RadevSvetlozar/pico_new/HARDWARE_CONNECTIONS_BG.md

# Motherboard за Arduino Nano ESP32 — връзки

Документът отговаря на текущия firmware. Имената `D…` и `A…` са имената,
отпечатани върху Arduino Nano ESP32, а не суровите ESP32 GPIO номера.

## 1. Разпределение на пиновете

| Nano ESP32 | Посока | Връзка | Забележка |
|---|---:|---|---|
| D0 | вход | CONFIG бутон към GND | Активен LOW, използва `INPUT_PULLUP` |
| D1 | — | резерв | Остави test pad |
| D2 | вход | LoRa DIO0 | Не свързвай към RS485 |
| D3 | — | резерв | Остави test pad |
| D4 | вход | Digital input 1 | Само 3.3 V логика/сух контакт |
| D5 | вход | Digital input 2 | Само 3.3 V логика/сух контакт |
| D6 | вход | Digital input 3 | Само 3.3 V логика/сух контакт |
| D7 | изход | W5500 CS/SCS | Добави 10 kΩ pull-up към 3.3 V |
| D8 | вход | W5500 INT | Добави 10 kΩ pull-up към 3.3 V |
| D9 | изход | LoRa RESET | 3.3 V логика |
| D10 | изход | LoRa NSS/CS | Добави 10 kΩ pull-up към 3.3 V |
| D11 | изход | SPI MOSI | Обща линия LoRa + W5500 |
| D12 | вход | SPI MISO | Обща линия LoRa + W5500 |
| D13 | изход | SPI SCK | Обща линия LoRa + W5500 |
| A0 | аналогов вход | NTC divider | 10 kΩ NTC, B=3950 |
| A1 | изход | GSM power-rail enable | Към EN на load switch, не към VBAT |
| A2 | UART RX | SIM7600 TXD | Кръстосана UART връзка |
| A3 | UART TX | SIM7600 RXD | Carrier-ът трябва да приема 3.3 V UART |
| A4 | UART TX | RS485 DI / TXD | В текущия firmware не остава за I²C |
| A5 | UART RX | RS485 RO / RXD| В текущия firmware не остава за I²C |
| A6 | — | резерв | Остави test pad |
| A7 | — | резерв | Остави test pad |

Всички модули трябва да имат обща логическа маса, освен ако интерфейсът не е
галванично изолиран.

## 2. LoRa слот — SX1276/RFM95, 868 MHz

| LoRa module | Nano ESP32 |
|---|---|
| VCC / 3V3 | 3.3 V |
| GND | GND |
| SCK | D13 |
| MISO | D12 |
| MOSI | D11 |
| NSS / CS | D10 |
| RESET | D9 |
| DIO0 | D2 |

Допълнително:

- 100 nF + 10 µF между 3.3 V и GND, максимално близо до слота;
- 470–1000 µF електролитен кондензатор върху 3.3 V rail-а близо до LoRa
  слота, ако захранващият модул и пистите не поемат добре TX импулсите;
- 10 kΩ pull-up от NSS/CS към 3.3 V;
- 868 MHz антена или U.FL/SMA конектор;
- keep-out зона под и пред PCB антената, ако модулът използва такава;
- не включвай предаване без свързана подходяща антена.

Електролитният кондензатор трябва да е поне 6.3 V, low-ESR и с правилна
полярност:

```text
3.3 V ── (+ 470–1000 µF -) ── GND
```

Той не заменя 100 nF и 10 µF керамичните кондензатори непосредствено до
модула.

## 3. LAN слот — W5500 модул

Препоръката е готов 3.3 V W5500 модул/carrier с RJ45 и magnetics, а не гол
W5500 чип.

| W5500 module | Nano ESP32 |
|---|---|
| 3V3 | 3.3 V |
| GND | GND |
| SCK | D13 |
| MISO | D12 |
| MOSI | D11 |
| SCS / CS | D7 |
| INT | D8 |
| RESET | 10 kΩ към 3.3 V и 100 nF към GND |

Добави 100 nF + 10 µF до захранващите пинове на слота. LoRa и W5500 споделят
SPI, но всеки има отделен CS. И двата CS трябва да са HIGH по време на reset.
Дръж Ethernet differential pair-ите къси и следвай reference layout-а на
избрания carrier/RJ45.

## 4. GSM/LTE слот — SIM7600 carrier

Използвай carrier, който:

- приема отделно 5 V захранване с достатъчен пиков ток;
- има auto-start при подаване на захранване;
- има 3.3 V-съвместим UART;
- извежда SIM holder и антенен конектор.

| SIM7600 carrier | Motherboard |
|---|---|
| 5V/VIN | отделна GSM 5 V rail |
| GND | обща GND |
| TXD | Nano A2 (RX) |
| RXD | Nano A3 (TX) |
| GSM rail EN | Nano A1 чрез load-switch EN |
| MAIN ANT | LTE антена |
| GNSS ANT | GNSS антена, само ако се използва |

`A1` не захранва модема. Той управлява EN на подходящ load switch или enable
на GSM buck regulator. Добави 100 kΩ pull-down на EN, за да е изключен rail-ът
при reset.

За GSM rail предвиди според carrier-а поне:

- 5 V / 3 A buck regulator;
- 470–1000 µF low-ESR bulk capacitor близо до слота;
- 10 µF + 100 nF ceramic capacitors;
- широка power писта/полигон и директен ground return;
- SIM и LTE ESD защита според reference design-а на carrier-а.

Не свързвай директно гол SIM7600 module към 3.3 V UART или към 5 V без
съответния reference power/level-shifting design.

## 5. RS485 порт

Текущият firmware не управлява DE/RE, затова използвай 3.3 V RS485 модул с
автоматична посока.

| Auto-direction RS485 | Nano ESP32 |
|---|---|
| VCC | 3.3 V |
| GND | GND |
| RO / TXD | A5 (RX) |
| DI / RXD | A4 (TX) |
| A | Клема RS485 A |
| B | Клема RS485 B |

До външния конектор добави:

- SM712 или еквивалентна RS485 TVS защита;
- 120 Ω termination с jumper/DIP switch;
- fail-safe bias резистори с jumper, само на едно място в шината;
- GND/reference клема;
- по възможност galvanically isolated RS485 вариант за индустриална среда.

Не поставяй постоянно 120 Ω на всяка платка — termination има само в двата
физически края на шината.

## 6. Три цифрови входа

Firmware-ът конфигурира D4, D5 и D6 като `INPUT_PULLUP`.

За локален сух контакт:

```text
3.3 V ── 10 kΩ ──┬── D4/D5/D6
                  |
               контакт
                  |
                 GND
```

Добави 1 kΩ последователен резистор към MCU пина и 100 nF към GND за хардуерен
филтър. Отворен контакт се чете като `1`, затворен като `0`.

За 12/24 V полеви вход не свързвай сигнала директно. Използвай optocoupler или
industrial digital-input front-end. Примерно за 24 V и обикновен optocoupler:

```text
FIELD+ ── 4.7 kΩ / 0.25 W ── opto LED ── FIELD-
3.3 V  ── 10 kΩ ──┬── D4/D5/D6
                   └── opto collector
GND ─────────────────── opto emitter
```

Добави reverse diode през opto LED и подходяща surge/ESD защита на конектора.

## 7. NTC термистор

Кодът на Nano ESP32 е за 10 kΩ NTC, B=3950, и 10 kΩ фиксиран резистор:

```text
3.3 V ── NTC 10 kΩ/B3950 ──┬── A0
                            |
                           10 kΩ 1%
                            |
                           GND
```

Добави 100 nF от A0 към GND. Постави термистора далеч от SIM7600, buck
регулаторите и други топли компоненти, ако целта е температура на околната
среда.

## 8. CONFIG бутон и сервизни връзки

```text
3.3 V ── 10 kΩ ──┬── D0
                  |
               бутон
                  |
                 GND
```

Firmware-ът активира и вътрешния pull-up; външният 10 kΩ е препоръчителен за
по-стабилна motherboard схема.

Последователност за Access Point:

1. Натисни и задръж CONFIG бутона.
2. Рестартирай Nano ESP32 или изключи и включи захранването.
3. Продължи да държиш бутона, докато започне индикацията за setup mode.
4. Свържи се към `ESP32-Setup` и отвори `http://192.168.10.1`.

Пинът се проверява само по време на startup. Натискане без рестарт няма да
стартира портала. Остави test pads за 3.3 V, GND, D1, D3, A6 и A7.

## 9. Захранване от 230 VAC към 3.3 VDC

Използвай само галванично изолиран, сертифициран и затворен AC/DC модул.
Мрежовата 230 VAC част не трябва да бъде достъпна от нисковолтовите конектори,
USB, бутоните или монтажните отвори.

```text
L ── предпазител ── AC/DC L
N ──────────────── AC/DC N
PE ─────────────── защитно заземяване/корпус, когато е приложимо

Изолиран AC/DC 3.3 V+
   ├── Nano ESP32 3V3
   ├── LoRa VCC
   ├── W5500 3V3
   └── 3.3 V RS485 logic

Изолиран AC/DC 3.3 V-
   └── обща нисковолтова GND
```

За директно захранване на Nano ESP32 през `3V3` трябва да прекъснеш означената
`3.3V` писта/jumper от долната страна на Arduino платката, както е описано от
Arduino. След прекъсването USB не може да захранва платката и не трябва да се
използва за upload, докато връзката не бъде възстановена със спойка. Не
включвай едновременно външните 3.3 V и USB.

3.3 V rail-ът трябва да е добре регулиран и да не превишава допустимото
напрежение на Nano ESP32 и модулите. Предвиди достатъчен ток за Nano ESP32,
Wi-Fi, W5500, LoRa TX и RS485 едновременно, с резерв за стартови импулси.

SIM7600 не трябва да се включва към този 3.3 V rail. За него остави отделен
изолиран AC/DC или DC/DC източник според входа на избрания carrier, обичайно
5 V с висок пиков ток:

```text
Отделен изолиран GSM supply ── load switch ── SIM7600 carrier VIN
                                      EN ──── Nano A1
GSM supply GND ────────────────────────────── low-voltage GND
```

Ако искаш един общ AC/DC модул за цялата платка, избери по-високо DC
напрежение и направи отделни 3.3 V и GSM rails с два DC/DC преобразувателя.

До всеки слот сложи отделен 100 nF и поне 10 µF. До входния конектор предвиди
подходящ предпазител. Спазвай creepage/clearance разстоянията от datasheet-а
на AC/DC модула и приложимия стандарт; не прокарвай copper pour или
нисковолтови писти през isolation зоната.

## 10. PCB layout checklist

- Не прокарвай SPI/UART/analog линии под LTE или LoRa антените.
- Остави copper keep-out според документацията на конкретната антена.
- Дръж W5500/RJ45 Ethernet pair-ите като 100 Ω differential и следвай
  reference design-а на избрания модул.
- Дръж NTC/A0 далеч от buck inductors, SIM7600 и RF линии.
- Постави GSM bulk capacitor максимално близо до GSM слота.
- Постави ESD/TVS елементите непосредствено до външните конектори.
- Добави ясни silkscreen означения за pin 1, напрежение и ориентация на всеки
  сменяем модул.
- Не допускай едновременно активни CS линии D7 и D10.
- Ако ще използваш I²C в бъдеще, премести RS485 от A4/A5 и промени firmware-а.
