RadevSvetlozar/pico_new/RADIO_ANALYSIS_BG.md

# Дистанционно сканиране с известни UID първо

Изисква ESP32 1.4.23, Node.js и frontend от тази промяна. Pro Mini и радио
протоколът не се променят. Използват се съществуващите UID/v2 заявки и TTL.

## Последователност

1. Известните UID се събират от записаните устройства, по-ранни отчети,
   успешни индивидуални ping проверки и профилите в ESP32 NVS.
2. ESP32 проверява всеки известен UID последователно: 3 радио-only заявки
   с TTL 0. Ако има директен отговор, препращане не се пробва.
3. Само при 0/3 директни отговора се правят още 3 опита с TTL 2.
4. След проверката на известните UID има три broadcast discovery прохода
   за нови платки. Потвърдените платки остават в текущия отчет независимо
   дали broadcast-ът ги намира. Broadcast не е критерий за изтриване.
5. Новооткритите UID се проверяват по същия директен/резервен режим.

Известният UID се помни, но това не означава постоянно reachable. Всеки
нов анализ събира нови отговори; липсващите показват 0/3, а не фалшив успех.
Лимитът е 8 проверявани UID за анализ. Отчетът отбелязва ограничението,
ако има още кандидати. До 12 минути при много недостъпни платки.

Когато се подаде node_uid без analyze=true (например проверка при добавяне
на устройство), ESP32 проверява само този UID, без broadcast discovery.
Това премахва зависимостта на индивидуалната проверка от общото откриване.

## Използване и резултати

MQTT устройства → Радио сканиране — на живо → „Анализирай радио мрежата“.
Стартът връща HTTP 202; страницата следи API и live MQTT/Bluetooth събития.
Отчетът се пази в PostgreSQL radio_analysis_reports. radio_known_nodes
пази установените UID между отделни сканирания и рестарти на сървъра.
ESP32 пази предпочитанията в NVS config/radioProfiles.

Отчетът съдържа scan_strategy=known_uid_first и по UID брой опити/отговори,
процент и средно време/RSSI/SNR. relay_tested=false означава, че не са
правени relay опити, защото има директен отговор; това не е 0% успеваемост.
Три опита са малка извадка, а не гаранция за дългосрочна надеждност.

Радио-only пробата използва неподдържан CAN target/function 0. Инсталираният
UID firmware на Pro Mini връща unsupported_function без Modbus/GPIO достъп.
Всеки корелиран отговор е радио успех. Modbus 226 не е радио timeout.
TTL 2 позволява препращане, но не доказва конкретен маршрут. Discovery path
описва заявката, а не гарантиран обратен път.

По време на анализа polling-ът е паузиран; нови заявки получават busy.
Анализът се отказва, ако има чакащи writes. Read може да се повтори веднъж
с другия TTL; write не се повтаря автоматично. Явно зададеният TTL има
предимство пред профила. При три пропуснати автоматични заявки се сменя
предпочитаният TTL и се маркира needs_recheck.

POST/GET /api/device-onboarding/lora-analysis използват gateway_id и Bearer
токен. Dev/developer/admin и ROLE_ вариантите имат достъп като в MQTT
регистъра; останалите потребители — само до своите обекти. Индивидуалният
POST /api/device-onboarding/lora-ping продължава да работи с ESP32 1.4.22.

Промените не са физически проверени върху отдалечените платки. За новата
последователност се обновява само ESP32 (OTA), backend и frontend.
