RadevSvetlozar/pico_new/pcb-motherboard/README_BG.md

# Nano ESP32 modular gateway – PCB rev A

Това е прототипна двуслойна motherboard за Arduino Nano ESP32 с места за:

- RFM95W LoRa (16 × 16 mm, 2 mm pitch; използва се адаптер с пинове);
- XY-485 с 4-пинов TTL конектор `GND RXD TXD VCC`;
- WIZ850io Ethernet;
- Waveshare SIM7600G-H HAT;
- 38 × 23 mm капсулован AC/DC модул 230 VAC → 3.3 VDC;
- AP/config бутон, NTC 10 kΩ, три локални входа и филтриращ кондензатор.

RS485 UART връзката е кръстосана: `A4 (Nano TX)` отива към `RXD/DI` на
XY-485, а `A5 (Nano RX)` идва от `TXD/RO` на XY-485. Това съответства на
`TX1_PIN = A4` и `RX1_PIN = A5` във firmware-а.

## Важна безопасност

Зоната вляво от вертикалната линия е под опасно мрежово напрежение. Платката е
прототип и **не е сертифицирана**. Преди включване към 230 VAC трябва да бъде
прегледана от квалифициран електротехник. Използвай затворена негорима кутия,
предпазител T500 mA, MOV 275 VAC и защитена клема. Не пипай и не свързвай USB,
докато платката е под мрежово напрежение.

SIM7600 не се захранва от 3.3 V модула. Подай отделни стабилизирани 5 V / минимум
3 A на клема `GSM 5V`, като масата е обща.

## Печат

PDF файловете са 1:1. Изключи `Fit to page` и печатай на 100%.

- `B_Cu_MIRRORED_1TO1.pdf` – долен меден слой, огледален за тонер трансфер.
- `F_Cu_1TO1.pdf` – горен слой. За домашна изработка може да се реализира с
  изолирани проводникови мостове вместо второ ецване.
- `FABRICATION_DRAWING_1TO1.pdf` – контур, отвори и надписи за проверка.

Преди ецване измери тестовия квадрат и физическите модули. Евтините XY-485 и
AC/DC модули имат различни ревизии; не пробивай, ако разстоянията не съвпадат.

## Размерен чертеж и таблици

[DIMENSIONS_BG.html](dimensions/DIMENSIONS_BG.html) съдържа разположение,
чертежи на двата медни слоя и пълни таблици за 19 елемента/монтажни места,
130 площадки и 139 сегмента на пистите. Всички координати са в mm спрямо
горния ляв край на платката. SVG чертежите са за печат 1:1 на A4 landscape,
100%, без автоматично мащабиране. Таблиците са налични и като CSV.

Размерите са извлечени от действителния `.kicad_pcb` файл чрез
`python3 generate_dimensions.py`. Нарисуваните контури на модулите са места
от проекта, а не проверени физически габарити. Документът не удостоверява
DRC, токова натоварваемост или изолация за 230 VAC.
