RadevSvetlozar/pico_new/pcb-motherboard/dimensions/pads.csv

ref | pin | x_mm | y_mm | pad_x_mm | pad_y_mm | drill_mm | net
H3 | 1 | 5.0 | 133.0 | 6.0 | 6.0 | 3.2
H1 | 1 | 5.0 | 5.0 | 6.0 | 6.0 | 3.2
J3 | 1 | 176.0 | 116.0 | 3.2 | 3.2 | 1.3 | +5V_GSM
J3 | 2 | 181.08 | 116.0 | 3.2 | 3.2 | 1.3 | GND
C1 | 1 | 64.0 | 13.0 | 2.4 | 2.4 | 0.9 | +3V3
C1 | 2 | 69.0 | 13.0 | 2.4 | 2.4 | 0.9 | GND
U5 | 1 | 176.0 | 50.0 | 2.2 | 2.2 | 1.0 | GSM_P1
U5 | 2 | 178.54 | 50.0 | 2.2 | 2.2 | 1.0 | +5V_GSM
U5 | 3 | 176.0 | 52.54 | 2.2 | 2.2 | 1.0 | GSM_P3
U5 | 4 | 178.54 | 52.54 | 2.2 | 2.2 | 1.0 | +5V_GSM
U5 | 5 | 176.0 | 55.08 | 2.2 | 2.2 | 1.0 | GSM_P5
U5 | 6 | 178.54 | 55.08 | 2.2 | 2.2 | 1.0 | GND
U5 | 7 | 176.0 | 57.62 | 2.2 | 2.2 | 1.0 | GSM_P7
U5 | 8 | 178.54 | 57.62 | 2.2 | 2.2 | 1.0 | A2_RX
U5 | 9 | 176.0 | 60.16 | 2.2 | 2.2 | 1.0 | GND
U5 | 10 | 178.54 | 60.16 | 2.2 | 2.2 | 1.0 | A3_TX
U5 | 11 | 176.0 | 62.7 | 2.2 | 2.2 | 1.0 | GSM_P11
U5 | 12 | 178.54 | 62.7 | 2.2 | 2.2 | 1.0 | GSM_P12
U5 | 13 | 176.0 | 65.24 | 2.2 | 2.2 | 1.0 | GSM_P13
U5 | 14 | 178.54 | 65.24 | 2.2 | 2.2 | 1.0 | GND
U5 | 15 | 176.0 | 67.78 | 2.2 | 2.2 | 1.0 | GSM_P15
U5 | 16 | 178.54 | 67.78 | 2.2 | 2.2 | 1.0 | GSM_P16
U5 | 17 | 176.0 | 70.32 | 2.2 | 2.2 | 1.0 | GSM_P17
U5 | 18 | 178.54 | 70.32 | 2.2 | 2.2 | 1.0 | GSM_P18
U5 | 19 | 176.0 | 72.86 | 2.2 | 2.2 | 1.0 | GSM_P19
U5 | 20 | 178.54 | 72.86 | 2.2 | 2.2 | 1.0 | GND
U5 | 21 | 176.0 | 75.4 | 2.2 | 2.2 | 1.0 | GSM_P21
U5 | 22 | 178.54 | 75.4 | 2.2 | 2.2 | 1.0 | GSM_P22
U5 | 23 | 176.0 | 77.94 | 2.2 | 2.2 | 1.0 | GSM_P23
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
U2 | 10 | 127.0 | 24.0 | 1.8 | 1.8 | 0.8 | GND
U2 | 11 | 127.0 | 22.0 | 1.8 | 1.8 | 0.8 | LORA_DIO3
U2 | 12 | 127.0 | 20.0 | 1.8 | 1.8 | 0.8 | LORA_DIO4
U2 | 13 | 127.0 | 18.0 | 1.8 | 1.8 | 0.8 | +3V3
U2 | 14 | 127.0 | 16.0 | 1.8 | 1.8 | 0.8 | LORA_DIO0_ALT
U2 | 15 | 127.0 | 14.0 | 1.8 | 1.8 | 0.8 | LORA_DIO1
U2 | 16 | 127.0 | 12.0 | 1.8 | 1.8 | 0.8 | D2
J1 | 1 | 8.0 | 25.0 | 3.2 | 3.2 | 1.3 | AC_L
J1 | 2 | 13.08 | 25.0 | 3.2 | 3.2 | 1.3 | AC_N
H4 | 1 | 200.0 | 133.0 | 6.0 | 6.0 | 3.2
TH1 | 1 | 67.0 | 100.0 | 2.2 | 2.2 | 1.0 | +3V3
TH1 | 2 | 72.0 | 100.0 | 2.2 | 2.2 | 1.0 | A0
F1 | 1 | 23.0 | 25.0 | 2.8 | 2.8 | 1.1 | AC_L
F1 | 2 | 38.0 | 25.0 | 2.8 | 2.8 | 1.1 | AC_L_FUSED
