RadevSvetlozar/pico_new/pcb-motherboard/pdf/FABRICATION_DRAWING_1TO1.pdf

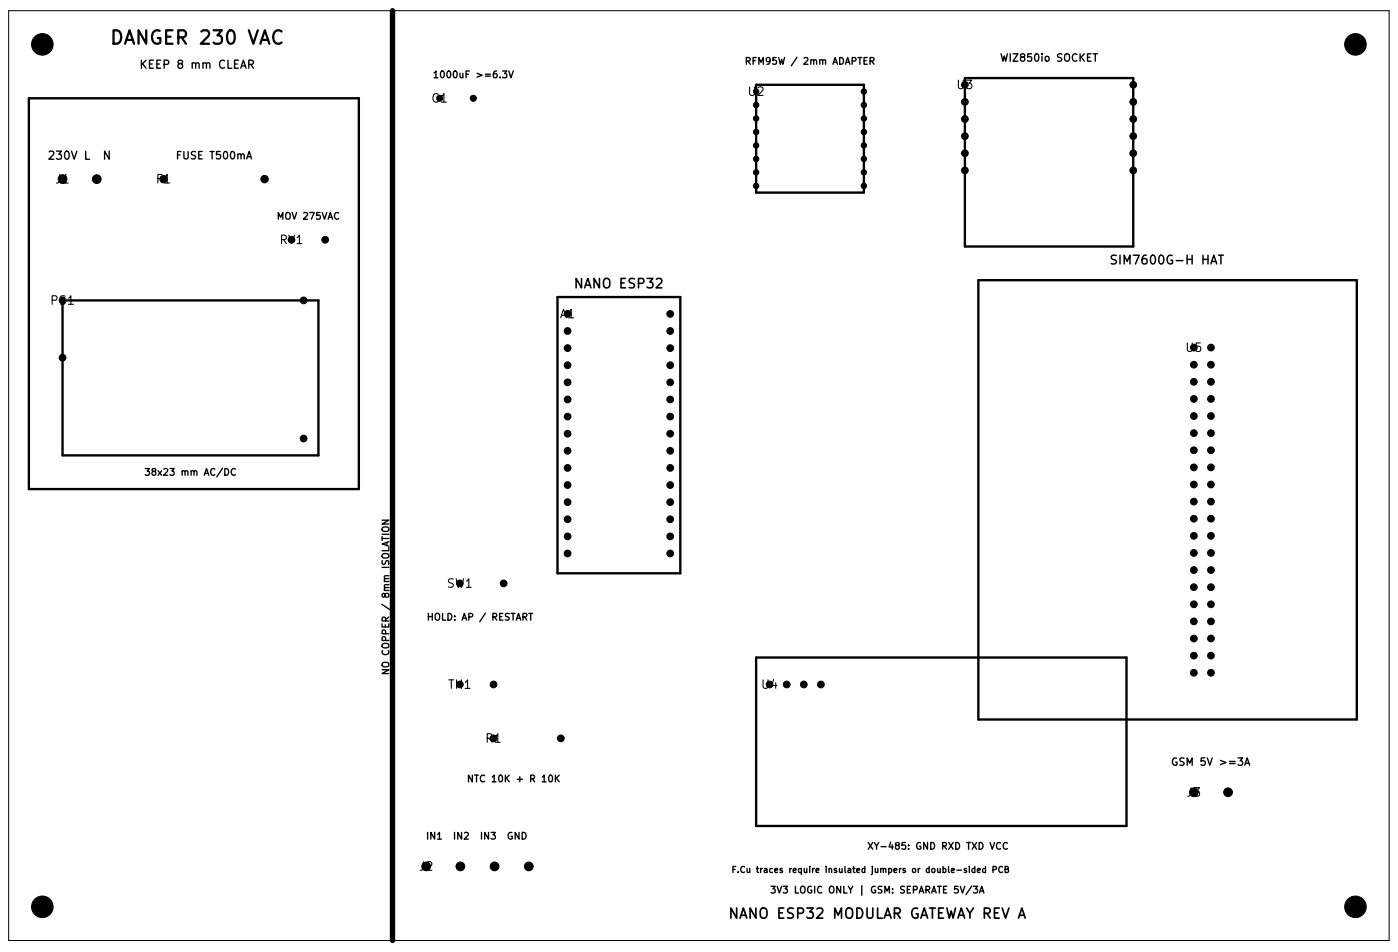
[picture p1: page 1]

3V3 LOGIC ONLY | GSM: SEPARATE 5V/3A XY-485: GND RXD TXD VCC NO COPPER / 8mm ISOLATION

IN1 IN2 IN3 GND HOLD: AP / RESTART NTC 10K + R 10K

NANO ESP32 MODULAR GATEWAY REV A
