RadevSvetlozar/pico_new/pcb-motherboard/pdf/B_Cu_MIRRORED_1TO1.pdf

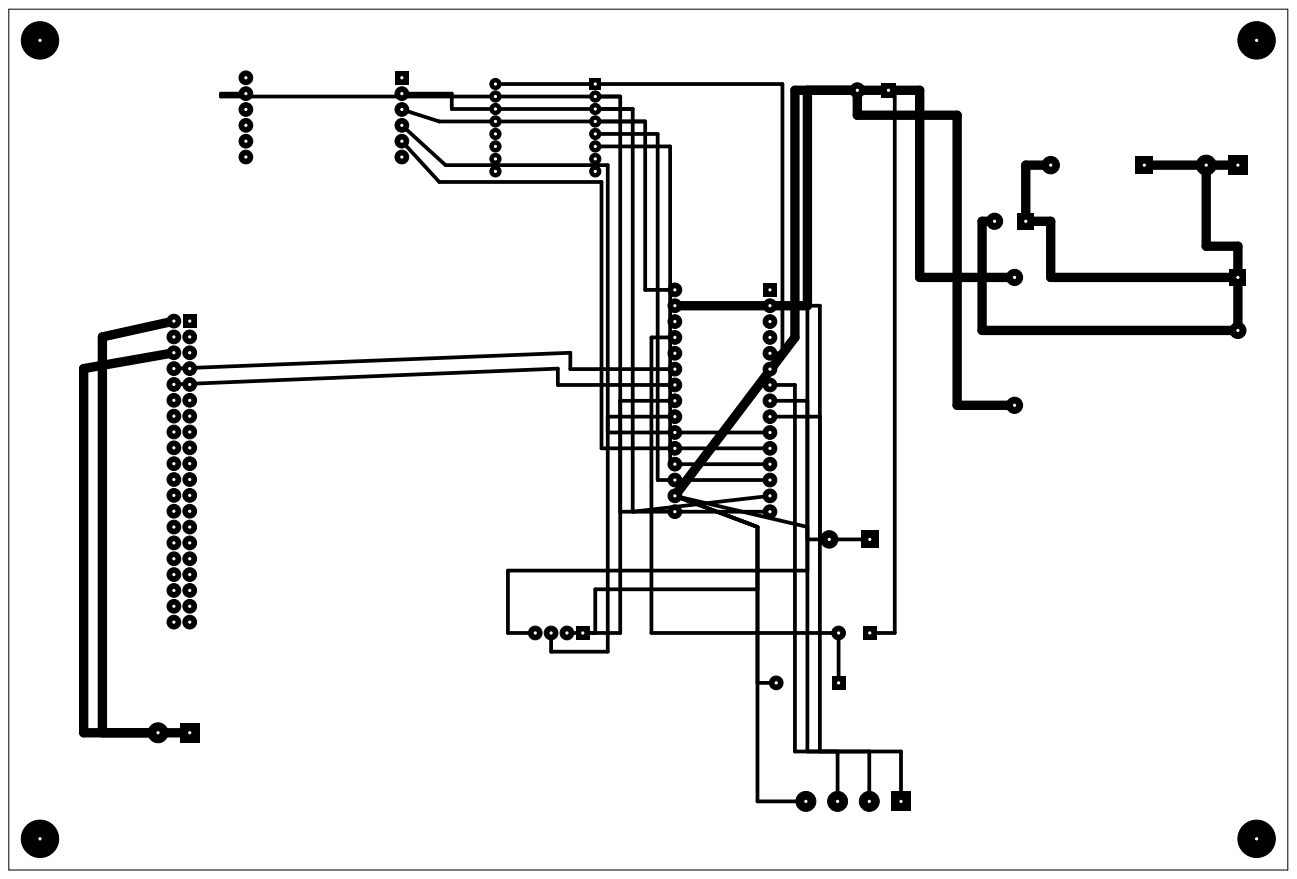
[picture p2: page 1]
