RadevSvetlozar/pico_new/pcb-motherboard/pdf/F_Cu_1TO1.pdf

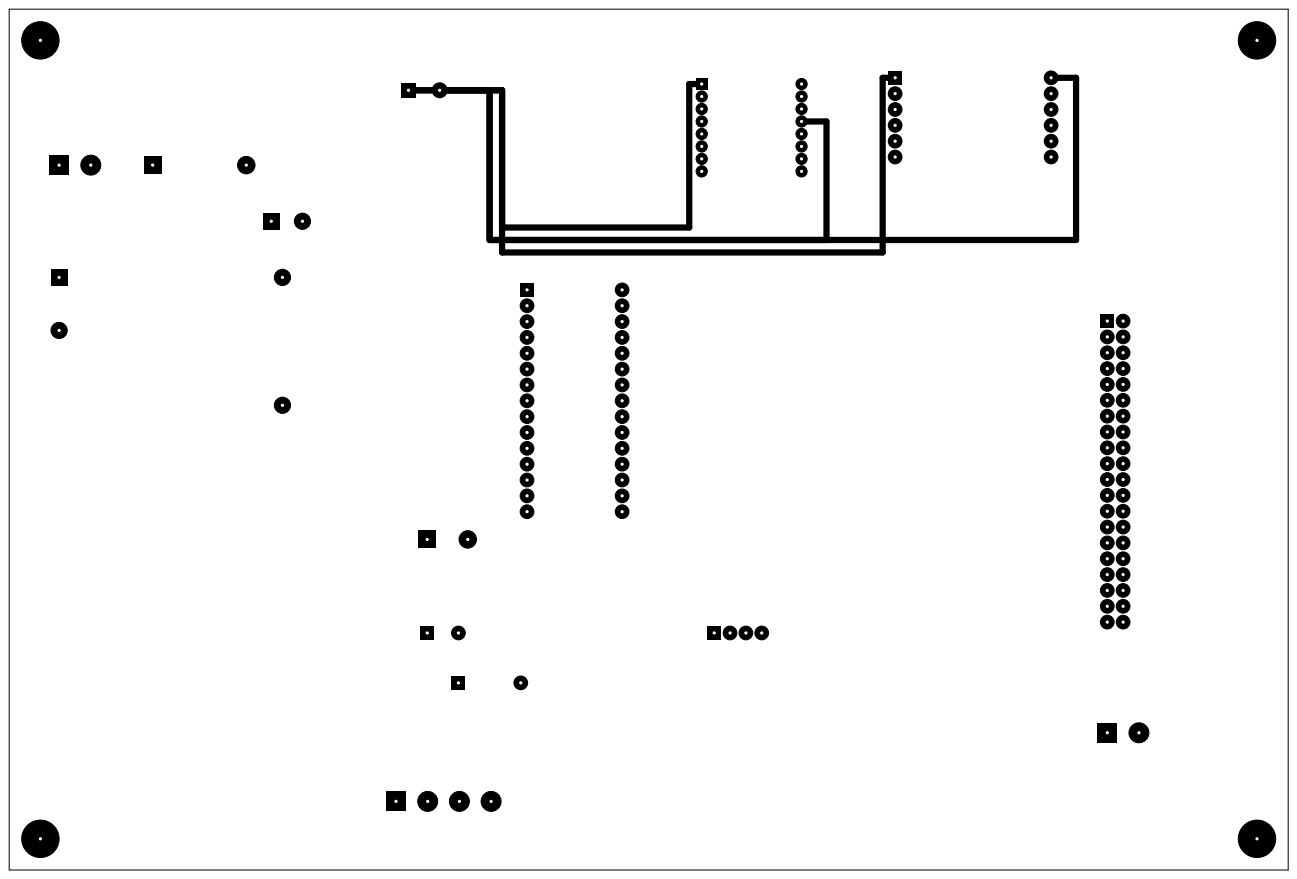
[picture p3: page 1]
