RadevSvetlozar/pico_new/pcb-motherboard/nano_esp32_modular_gateway.kicad_pcb

## KiCad design pcb-motherboard/nano_esp32_modular_gateway.kicad_pcb (2026-09-30)

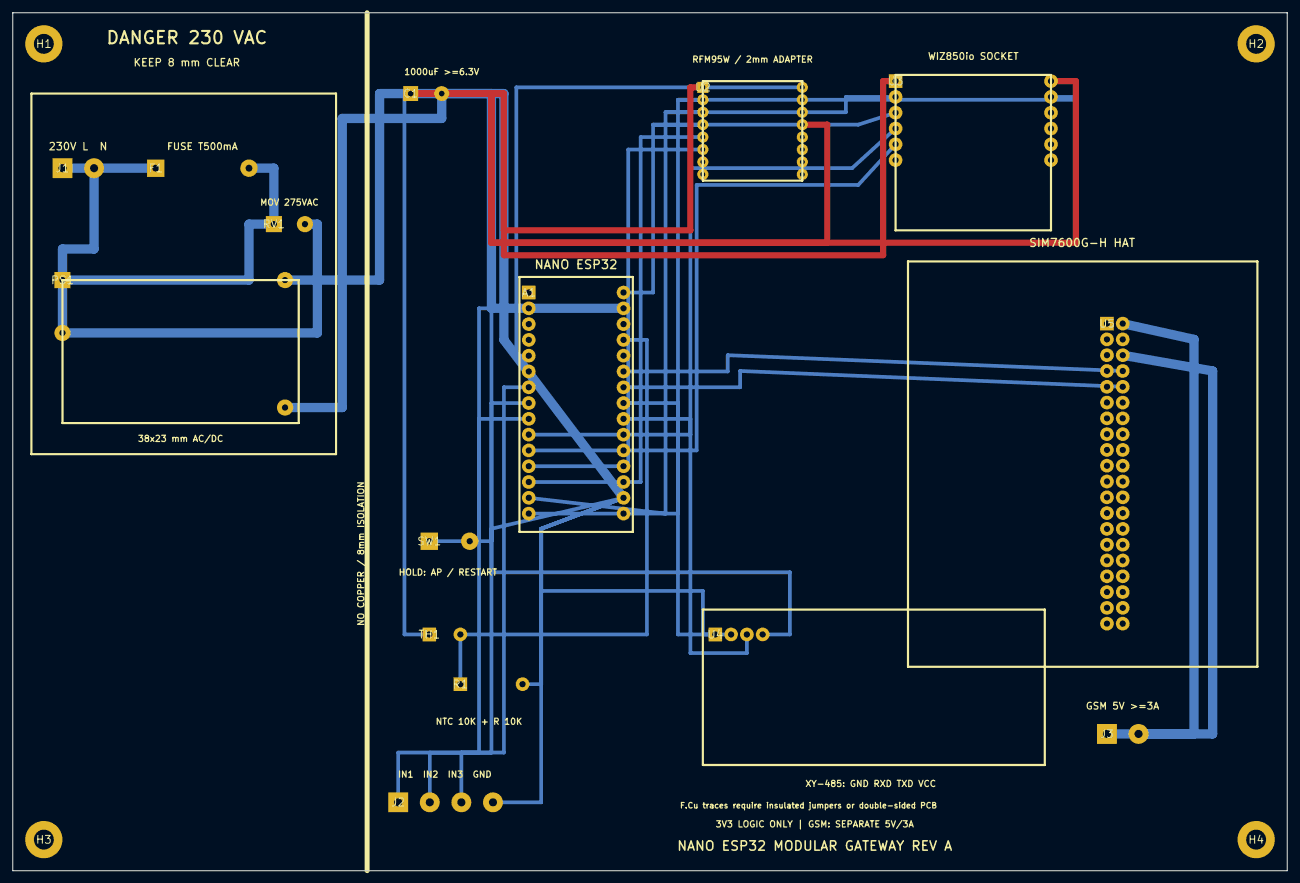
[picture p4: board nano_esp32_modular_gateway.kicad_pcb from above]

Board: 2 copper layers, 205.0 x 138.0 mm, 19 parts (0 on the bottom side), 24 nets.

Parts:
A1: Arduino_Nano_ESP32_socket
C1: 1000uF_6V3
F1: FUSE_T500mA
H1, H2, H3, H4: M3
J1: AC_IN_5.08
J2: LOCAL_INPUTS_5.08
J3: GSM_5V_IN_5.08
PS1: ACDC_38x23_3V3
R1: 10K
RV1: MOV_275VAC
SW1: AP_CONFIG_BUTTON
TH1: NTC_10K
U2: RFM95W_16x16_P2.0
U3: WIZ850io_socket
U4: XY-485_1x4
U5: SIM7600G-H_HAT_2x20

Connections:
+3V3: A1.29, C1.1, PS1.4, TH1.1, U2.13, U3.12, U4.4
+5V_GSM: J3.1, U5.2, U5.4
A0: A1.27, R1.1, TH1.2
A2_RX: A1.25, U5.8
A3_TX: A1.24, U5.10
A4_TX: A1.23, U4.2
A5_RX: A1.22, U4.3
AC_L: F1.1, J1.1
AC_L_FUSED: F1.2, PS1.1, RV1.1
AC_N: J1.2, PS1.2, RV1.2
D0_RX: A1.2, SW1.1
D2: A1.5, U2.16
D4: A1.7, J2.1
D5: A1.8, J2.2
D6: A1.9, J2.3
D7: A1.10, U3.4
D8: A1.11, U3.5
D9: A1.12, U2.6
D10: A1.13, U2.5
D11_MOSI: A1.14, U2.3, U3.2
D12_MISO: A1.15, U2.2, U3.11
D13_SCK: A1.30, U2.4, U3.3
GND: A1.4, A1.17, C1.2, J2.4, J3.2, PS1.3, R1.2, SW1.2, U2.1, U2.8, U2.10, U3.1, U3.7, U4.1, U5.6, U5.9, U5.14, U5.20, U5.25, U5.30, U5.34, U5.39
RESET: A1.3, A1.18, U3.6
