RadevSvetlozar/pico_new/(commit log)

2026-04-08 added reset button for factory reset
2026-07-14 temperature commit
2026-08-21 Add Nano ESP32 firmware 1.3.2
2026-09-30 Track Nano ESP32 PlatformIO firmware
    [nano_esp32_modular_gateway.kicad_pcb]
2026-09-30 Release Nano ESP32 firmware 1.4.10
2026-10-01 eddited request flow
2026-10-09 added deleting of gateway
    [components.csv, pads.csv, tracks.csv]
